Rayyan222003/AIR-TIGHT-CONTAINER-WITH-MECHANISM-FOR-DETACHABLE-SENSOR/README.md

# AIR-TIGHT-CONTAINER-WITH-MECHANISM-FOR-DETACHABLE-SENSOR
