Rayyan222003/AIR-TIGHT-CONTAINER-WITH-MECHANISM-FOR-DETACHABLE-SENSOR/SOLID WORKS/BOMB ASSEMBLY.SLDASM

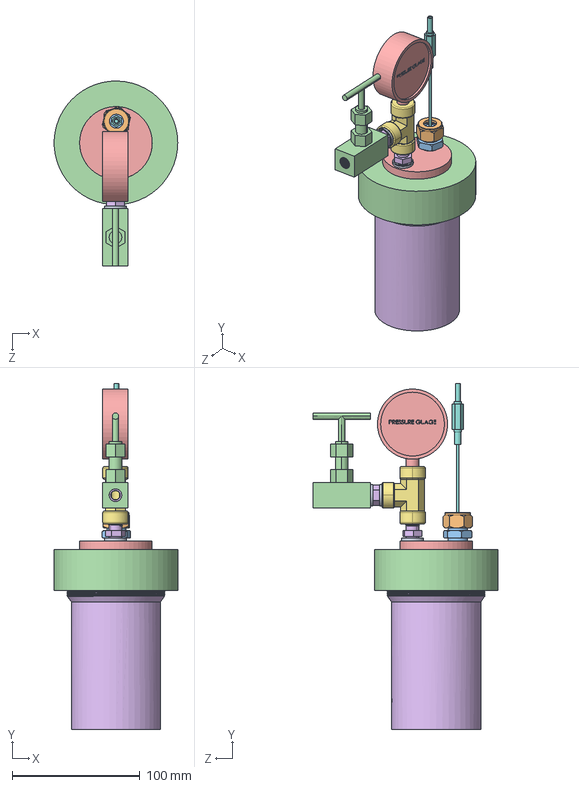
[picture p19: CAD file, 2024-11-11]
SOLID WORKS/BOMB ASSEMBLY.SLDASM
96.9 x 271.3 x 145.0 mm
BOTTLE1
INNER CAP1
OUTER CAP1
CONNECTOR
CONNECTOR CAP
INLET VALVE RUBBER x 3
SENSOR'
tee_connnector[1]
inlet_valve_connector x 2
PRESSURE GUAGE
CONTROLABLE VALVE1
SENSOR RUBBER
SENSOR SPRING PLATE
SENSOR SPRING INLET CONNECTOR
