Rayyan222003/AIR-TIGHT-CONTAINER-WITH-MECHANISM-FOR-DETACHABLE-SENSOR/SOLID WORKS/inlet_valve_connector.SLDPRT

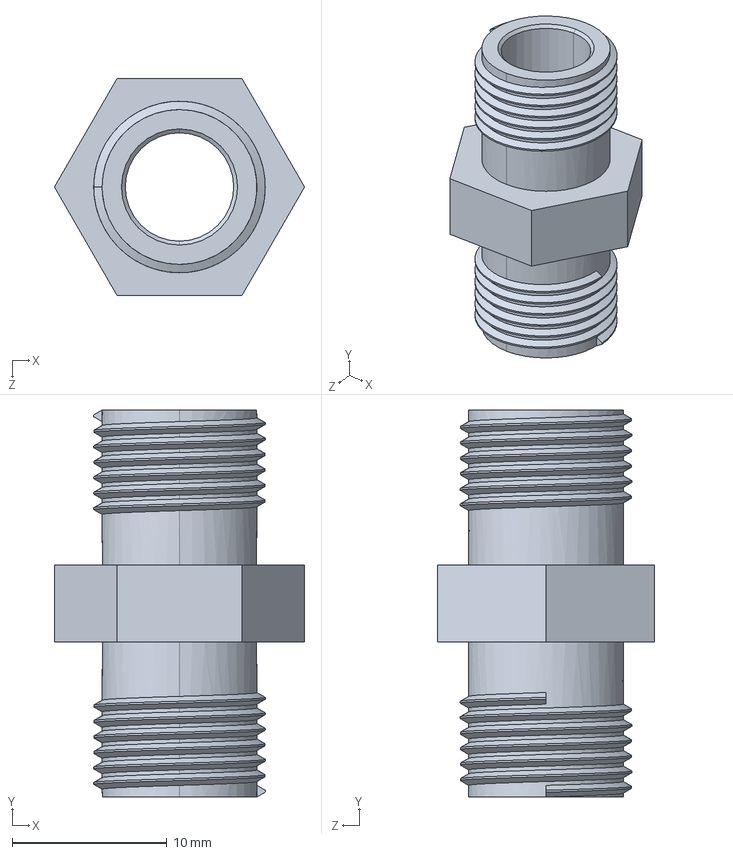
[picture p20: CAD file, 2024-11-11]
SOLID WORKS/inlet_valve_connector.SLDPRT
16.2 x 25.0 x 14.0 mm
