Rayyan222003/AIR-TIGHT-CONTAINER-WITH-MECHANISM-FOR-DETACHABLE-SENSOR/SOLID WORKS/OUTER CAP1.SLDPRT

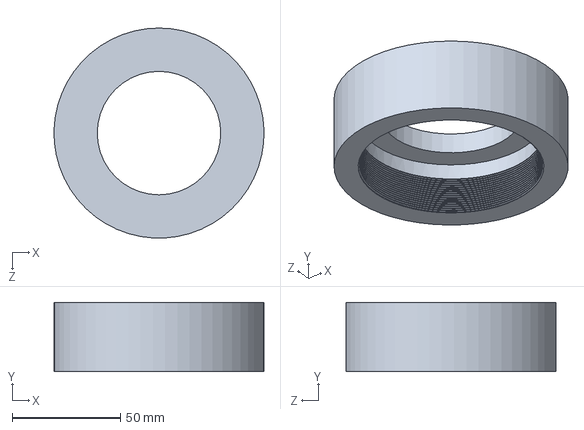
[picture p21: CAD file, 2024-11-11]
SOLID WORKS/OUTER CAP1.SLDPRT
97.0 x 32.0 x 96.9 mm
