Rayyan222003/AIR-TIGHT-CONTAINER-WITH-MECHANISM-FOR-DETACHABLE-SENSOR/SOLID WORKS/SENSOR'.SLDPRT

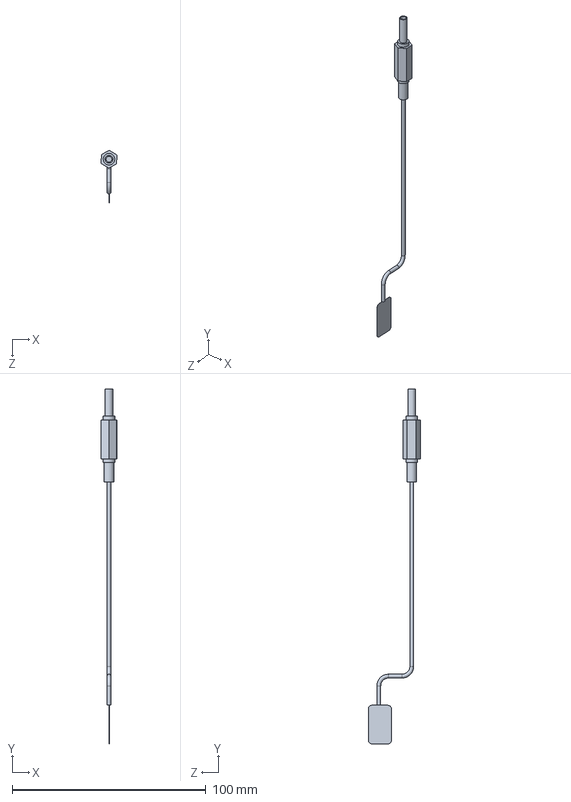
[picture p22: CAD file, 2024-11-11]
SOLID WORKS/SENSOR'.SLDPRT
8.08 x 183.0 x 27.1 mm
