Rayyan222003/AIR-TIGHT-CONTAINER-WITH-MECHANISM-FOR-DETACHABLE-SENSOR/SOLID WORKS/SENSOR SPRING INLET CONNECTOR.SLDPRT

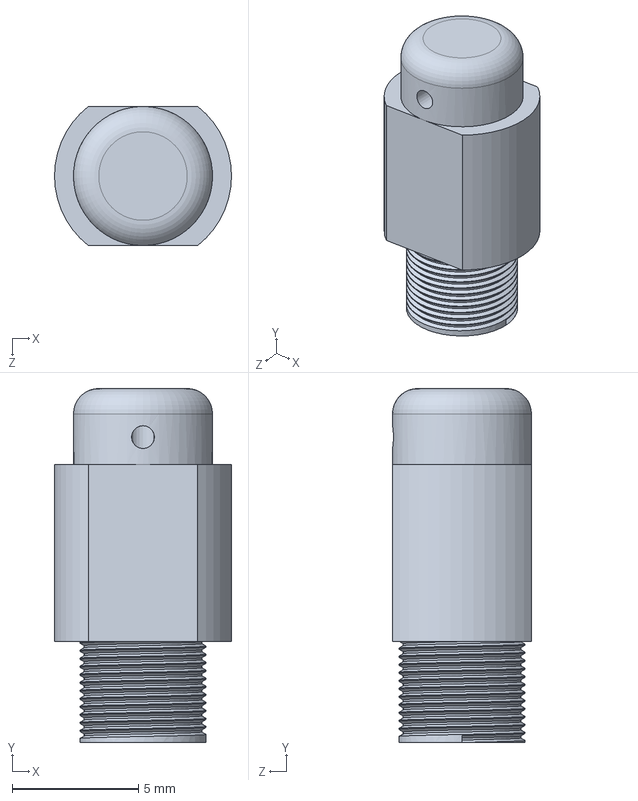
[picture p23: CAD file, 2024-11-11]
SOLID WORKS/SENSOR SPRING INLET CONNECTOR.SLDPRT
7.00 x 14.0 x 5.50 mm
