Rayyan222003/AIR-TIGHT-CONTAINER-WITH-MECHANISM-FOR-DETACHABLE-SENSOR/SOLID WORKS/INNER CAP1.SLDPRT

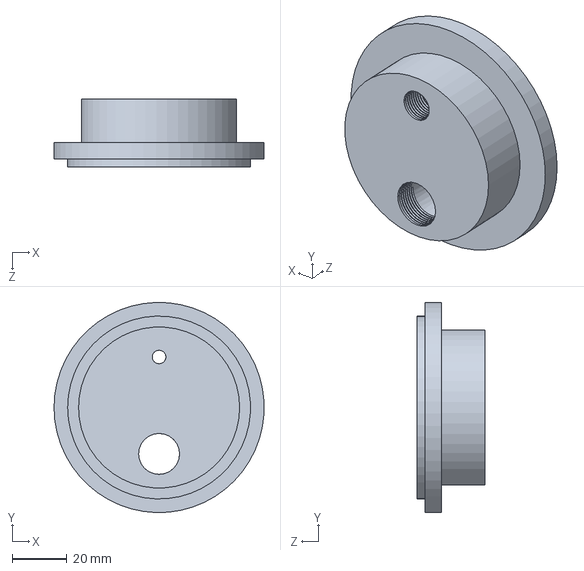
[picture p24: CAD file, 2024-11-11]
SOLID WORKS/INNER CAP1.SLDPRT
76.9 x 77.0 x 25.0 mm
