Rayyan222003/AIR-TIGHT-CONTAINER-WITH-MECHANISM-FOR-DETACHABLE-SENSOR/SOLID WORKS/SENSOR SPRING PLATE.SLDPRT

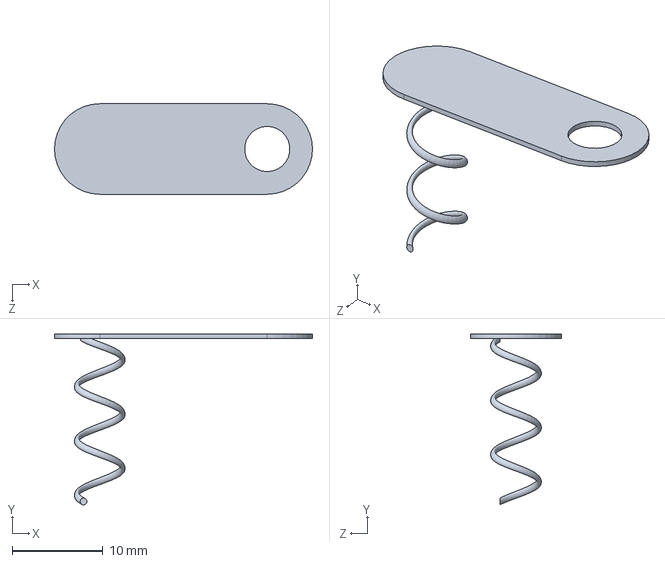
[picture p25: CAD file, 2024-11-11]
SOLID WORKS/SENSOR SPRING PLATE.SLDPRT
28.5 x 18.9 x 10.0 mm
