Rayyan222003/AIR-TIGHT-CONTAINER-WITH-MECHANISM-FOR-DETACHABLE-SENSOR/SOLID WORKS/CONNECTOR.SLDPRT

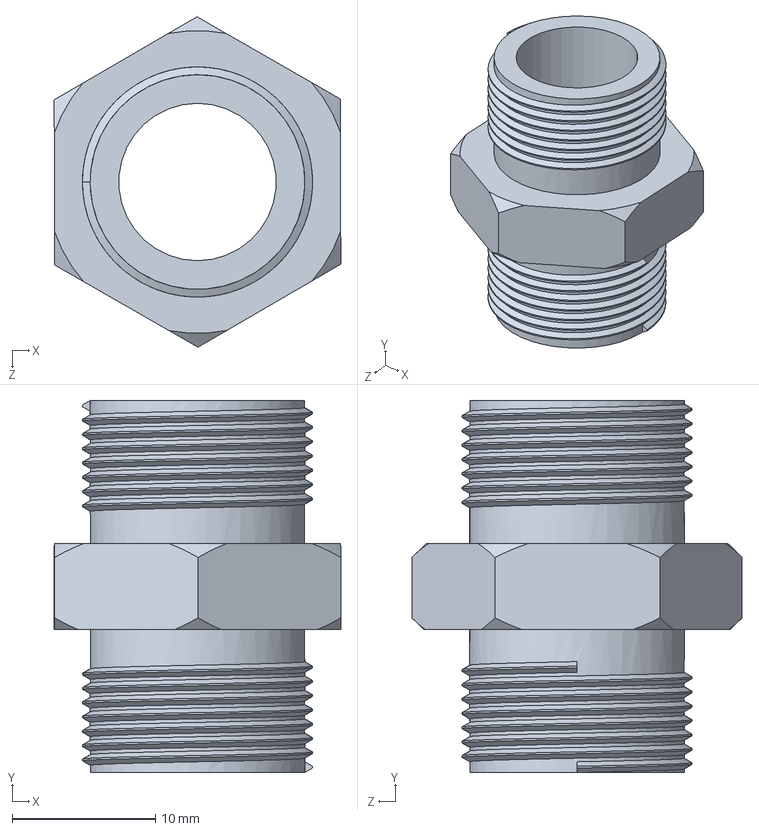
[picture p26: CAD file, 2024-11-11]
SOLID WORKS/CONNECTOR.SLDPRT
20.0 x 26.0 x 23.1 mm
