Rayyan222003/AIR-TIGHT-CONTAINER-WITH-MECHANISM-FOR-DETACHABLE-SENSOR/SOLID WORKS/CONTROLABLE VALVE1.SLDPRT

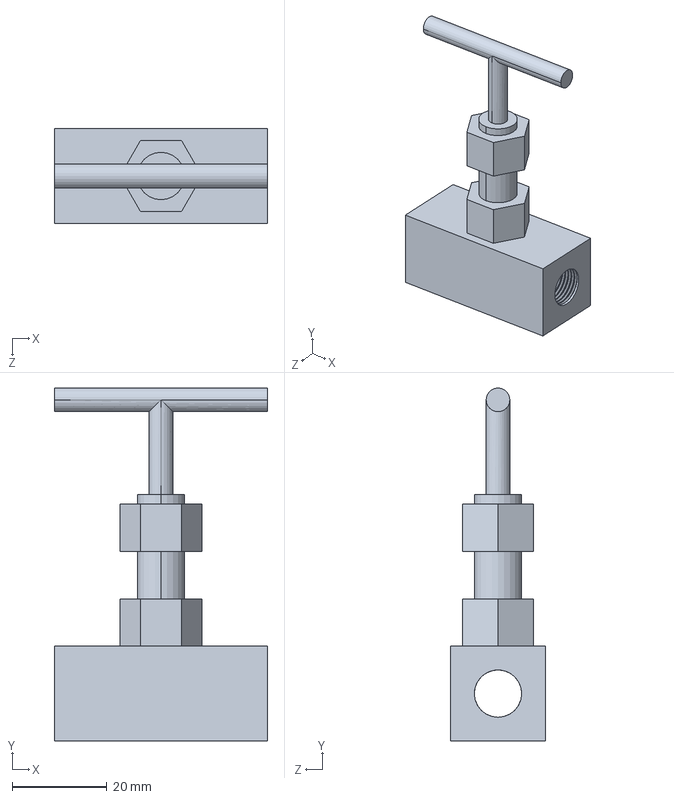
[picture p27: CAD file, 2024-11-11]
SOLID WORKS/CONTROLABLE VALVE1.SLDPRT
45.0 x 74.5 x 20.0 mm
