Rayyan222003/AIR-TIGHT-CONTAINER-WITH-MECHANISM-FOR-DETACHABLE-SENSOR/SOLID WORKS/BOTTLE1.SLDPRT

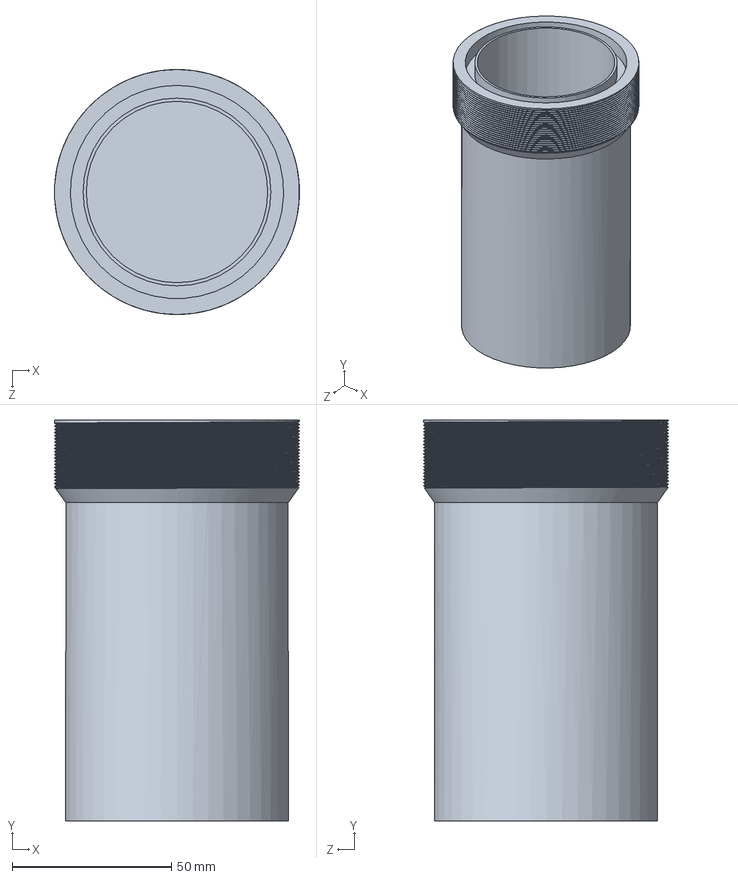
[picture p28: CAD file, 2024-11-11]
SOLID WORKS/BOTTLE1.SLDPRT
77.0 x 126.0 x 77.0 mm
