Rayyan222003/AIR-TIGHT-CONTAINER-WITH-MECHANISM-FOR-DETACHABLE-SENSOR/SOLID WORKS/CONNECTOR CAP.SLDPRT

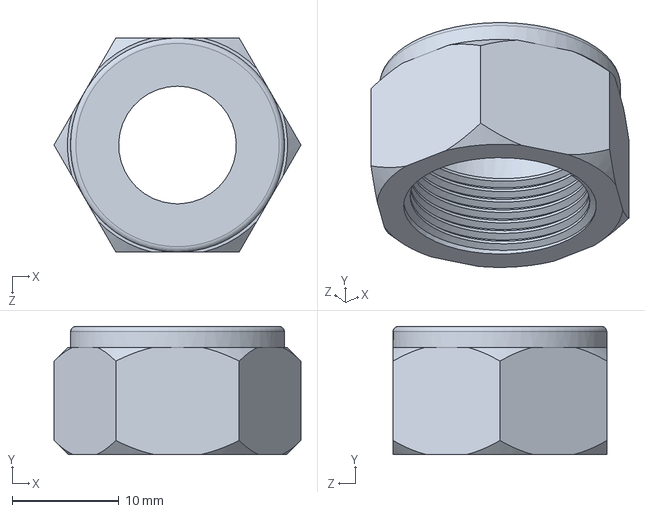
[picture p29: CAD file, 2024-11-11]
SOLID WORKS/CONNECTOR CAP.SLDPRT
23.1 x 12.0 x 20.0 mm
