Rayyan222003/AIR-TIGHT-CONTAINER-WITH-MECHANISM-FOR-DETACHABLE-SENSOR/SOLID WORKS/INLET VALVE1.SLDPRT

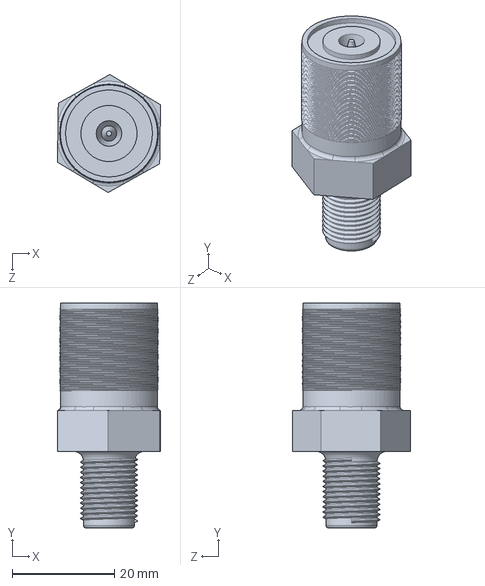
[picture p30: CAD file, 2024-11-11]
SOLID WORKS/INLET VALVE1.SLDPRT
20.2 x 44.0 x 23.1 mm
