Rayyan222003/AIR-TIGHT-CONTAINER-WITH-MECHANISM-FOR-DETACHABLE-SENSOR/SOLID WORKS/PRESSURE GUAGE.SLDPRT

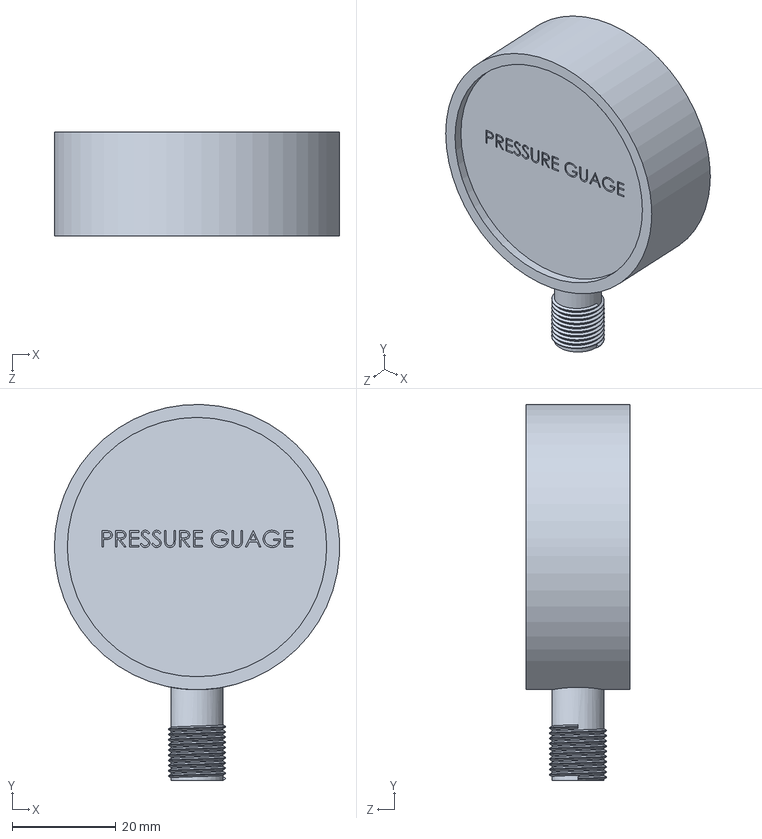
[picture p31: CAD file, 2024-11-11]
SOLID WORKS/PRESSURE GUAGE.SLDPRT
55.0 x 72.5 x 20.0 mm
