Rayyan222003/AIR-TIGHT-CONTAINER-WITH-MECHANISM-FOR-DETACHABLE-SENSOR/SOLID WORKS/tee_connnector[1].SLDPRT

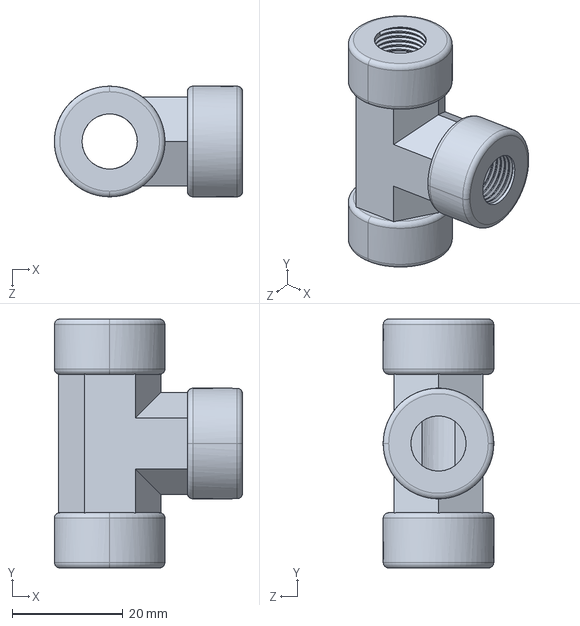
[picture p32: CAD file, 2024-11-11]
SOLID WORKS/tee_connnector[1].SLDPRT
34.0 x 45.0 x 20.0 mm
