Rayyan222003/AIR-TIGHT-CONTAINER-WITH-MECHANISM-FOR-DETACHABLE-SENSOR/SOLID WORKS/SENSOR RUBBER.SLDPRT

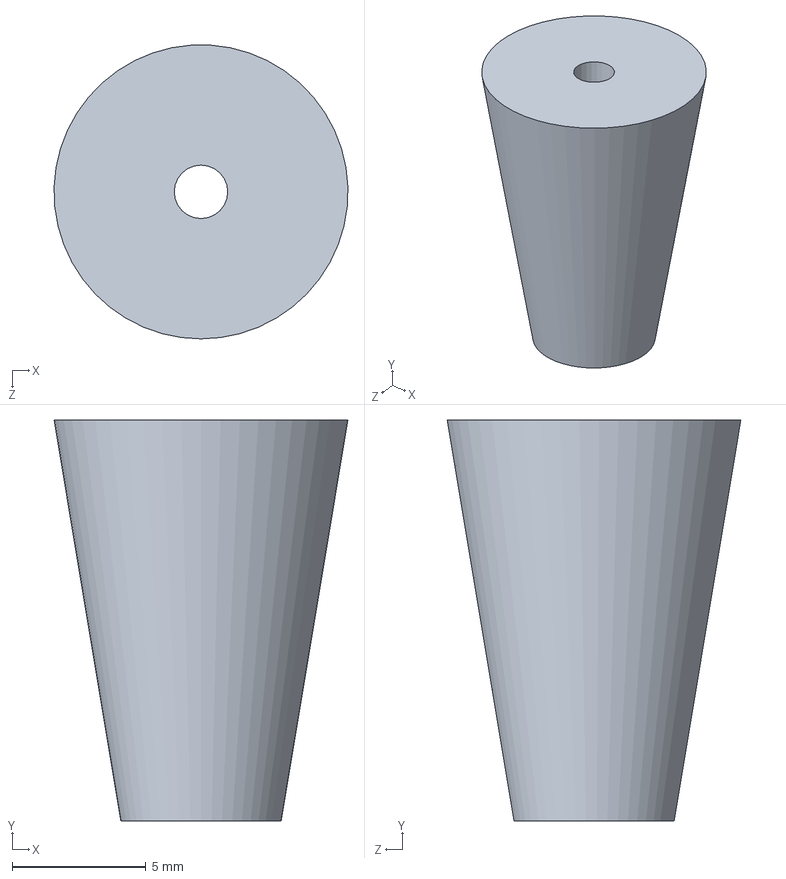
[picture p33: CAD file, 2024-11-11]
SOLID WORKS/SENSOR RUBBER.SLDPRT
11.0 x 15.0 x 11.0 mm
