Rayyan222003/AIR-TIGHT-CONTAINER-WITH-MECHANISM-FOR-DETACHABLE-SENSOR/SOLID WORKS/BONDED WASHERS/INLET VALVE RUBBER.SLDPRT

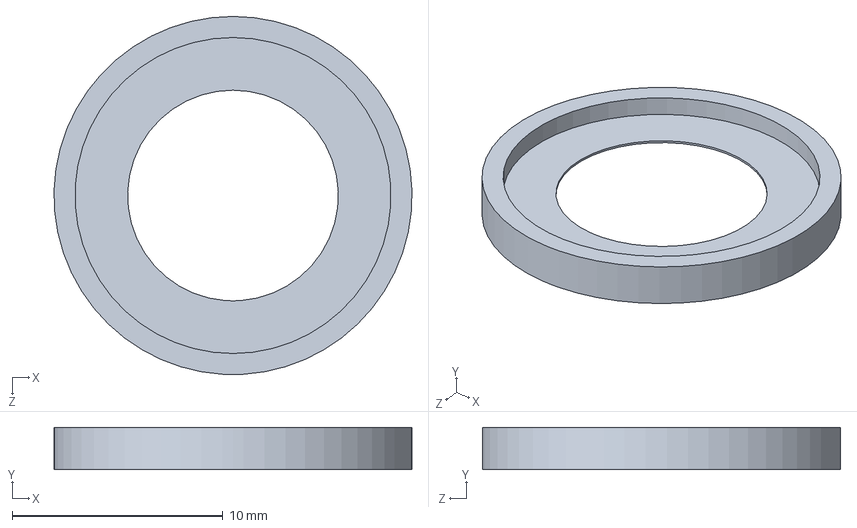
[picture p34: CAD file, 2024-11-11]
SOLID WORKS/BONDED WASHERS/INLET VALVE RUBBER.SLDPRT
17.0 x 2.00 x 17.0 mm
