Rayyan222003/AIR-TIGHT-CONTAINER-WITH-MECHANISM-FOR-DETACHABLE-SENSOR/SOLID WORKS/BONDED WASHERS/CONNECTOR WASHER ASSEMBLY.SLDASM

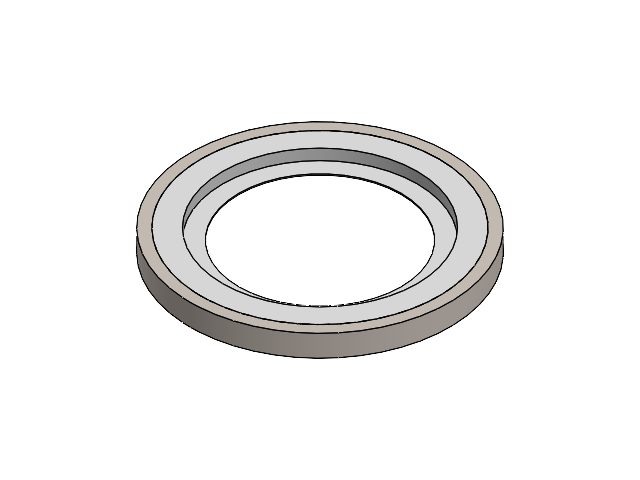
[picture p35: CAD file, 2024-11-11]
SOLID WORKS/BONDED WASHERS/CONNECTOR WASHER ASSEMBLY.SLDASM
CONNECTER RUBBER
CONNECTOR METAL PIECE
