Rayyan222003/AIR-TIGHT-CONTAINER-WITH-MECHANISM-FOR-DETACHABLE-SENSOR/SOLID WORKS/BONDED WASHERS/INLET VALVE BONDED WASHER.SLDASM

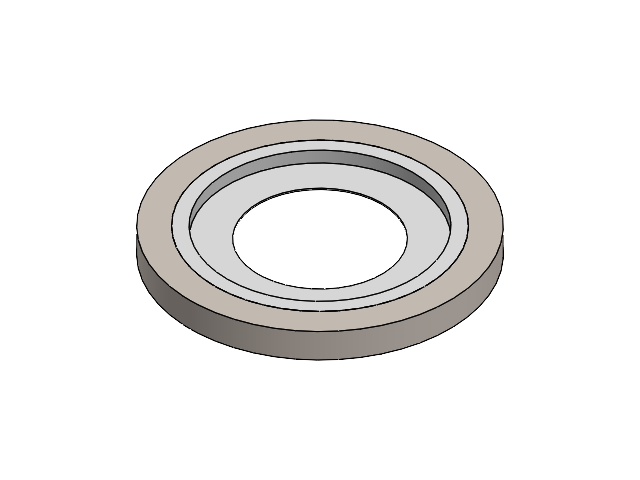
[picture p36: CAD file, 2024-11-11]
SOLID WORKS/BONDED WASHERS/INLET VALVE BONDED WASHER.SLDASM
INLET VALVE METAL PIECE
INLET VALVE RUBBER
