Rayyan222003/AIR-TIGHT-CONTAINER-WITH-MECHANISM-FOR-DETACHABLE-SENSOR/(list of files, cad)

Other CAD files:
SOLID WORKS/BONDED WASHERS/CONNECTER RUBBER.SLDPRT
SOLID WORKS/BONDED WASHERS/CONNECTOR METAL PIECE.SLDPRT
SOLID WORKS/BONDED WASHERS/INLET VALVE METAL PIECE.SLDPRT
SOLID WORKS/BONDED WASHERS/bull_nose 1.SLDPRT
SOLID WORKS/BONDED WASHERS/cv2.SLDPRT
SOLID WORKS/BONDED WASHERS/nose_connector 1.SLDPRT
SOLID WORKS/SENSOR RUBBER WASHER.SLDPRT
